jmharvey1/100mw-WSPR-Transmitter/README.md

# 100mw-WSPR-Transmitter
Material Needed to Replicate the 100mw Transmitter shown in the YouTube Video 
The Video can be seen here: https://youtu.be/ck376xusUuw
