jmharvey1/100mw-WSPR-Transmitter/EagleFiles/Adriuno_WSPR_Exciter/Arduino_VFO_AD9850.pdf

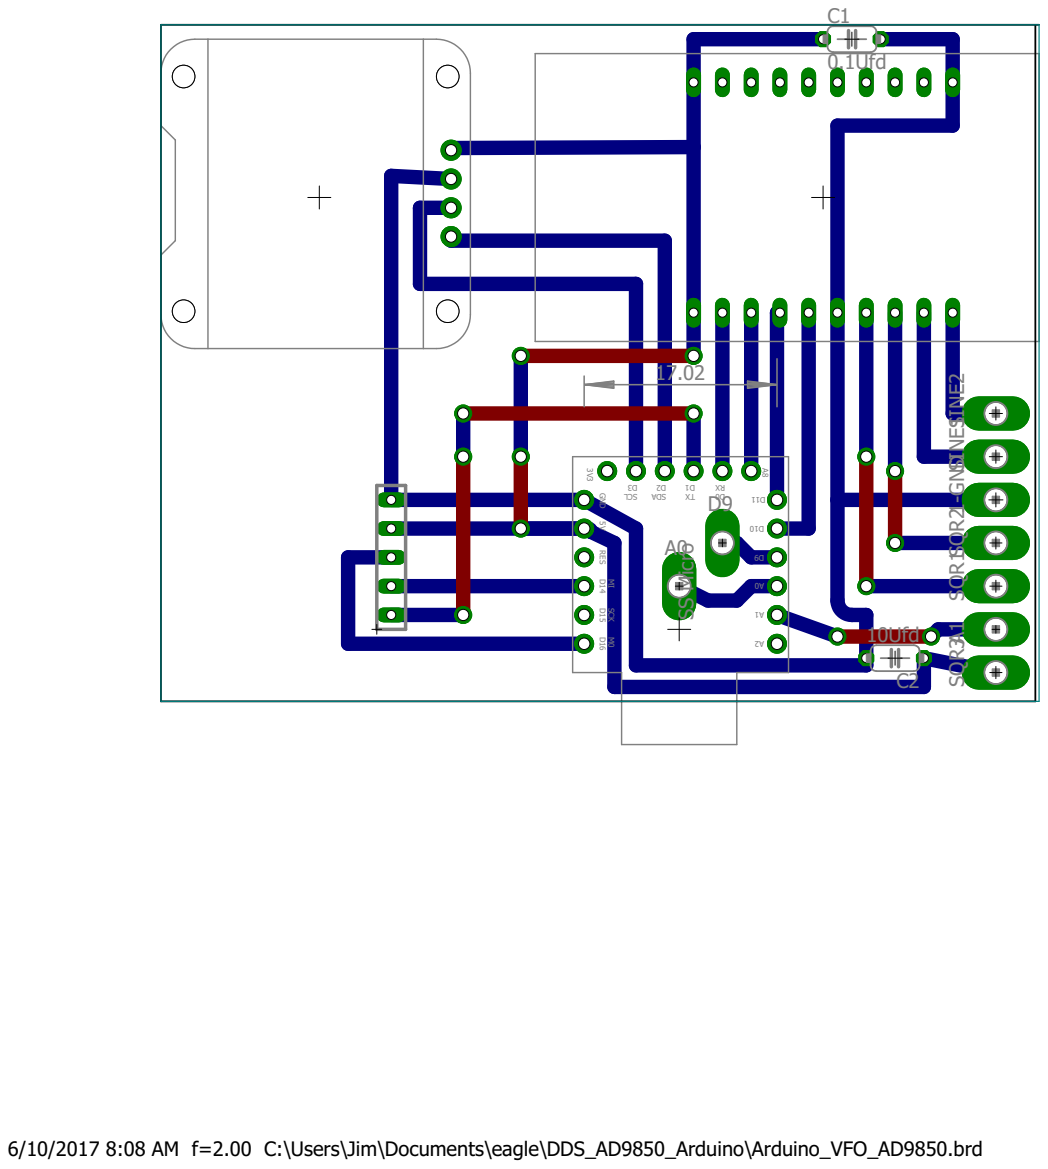
[picture p1: page 1]

6/10/2017 8:08 AM f=2.00 C:\Users\Jim\Documents\eagle\DDS_AD9850_Arduino\Arduino_VFO_AD9850.brd
