jmharvey1/100mw-WSPR-Transmitter/EagleFiles/Adriuno_WSPR_Exciter/Arduino_VFO_AD9850.brd

## EAGLE design EagleFiles/Adriuno_WSPR_Exciter/Arduino_VFO_AD9850.brd (2017-06-10)

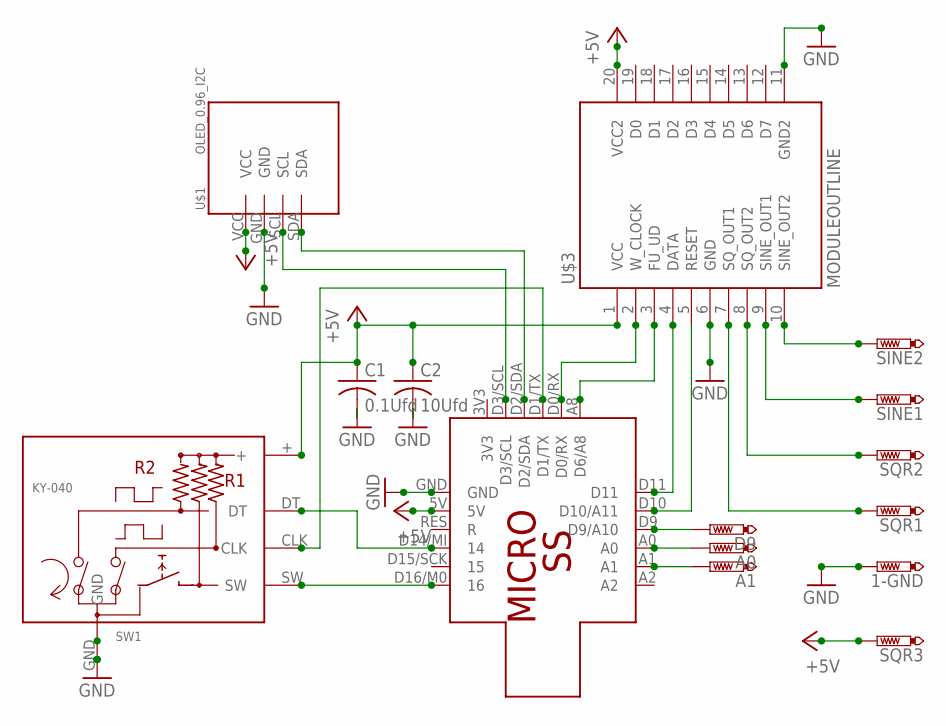
[picture p4: schematic Arduino_VFO_AD9850.sch]

Parts:
1-GND: 1 - GND; P1-20Y
A0, A1: 1 - GND; P1-20Y
C1: 0.1Ufd; C050-024X044
C2: 10Ufd; C050-024X044
D9: 1 - GND; P1-20Y
SINE1: 1 - GND; P1-20Y
SINE2: SINE2; P1-20Y
SQR1, SQR2, SQR3: 1 - GND; P1-20Y
SW1: KY-040; KY040
U$1: OLED_0.96_I2C
U$3: MODULEOUTLINE; MODULE_OUTLINE
U$4: SS_MICRO

Connections:
+5V: C1.1, C2.1, SQR3.TP, SW1.+, U$1.VCC, U$3.1 (VCC), U$3.20 (VCC2), U$4.5V
GND: 1-GND.TP, C1.2, C2.2, SW1.GND, U$1.GND, U$3.6 (GND), U$3.11 (GND2), U$4.GND
unnamed: U$1.SDA, U$4.D2/SDA
unnamed: U$1.SCL, U$4.D3/SCL
unnamed: SW1.CLK, U$4.D1/TX
unnamed: U$3.2 (W_CLOCK), U$4.D0/RX
unnamed: U$3.4 (DATA), U$4.D11
unnamed: U$3.5 (RESET), U$4.D10 (D10/A11)
unnamed: SW1.DT, U$4.D14/MI (14)
unnamed: SW1.SW, U$4.D16/M0 (16)
unnamed: SINE2.TP, U$3.10 (SINE_OUT2)
unnamed: SINE1.TP, U$3.9 (SINE_OUT1)
unnamed: SQR2.TP, U$3.8 (SQ_OUT2)
unnamed: SQR1.TP, U$3.7 (SQ_OUT1)
unnamed: D9.TP, U$4.D9 (D9/A10)
unnamed: A0.TP, U$4.A0
unnamed: A1.TP, U$4.A1
unnamed: U$3.3 (FU_UD), U$4.A8 (D6/A8)

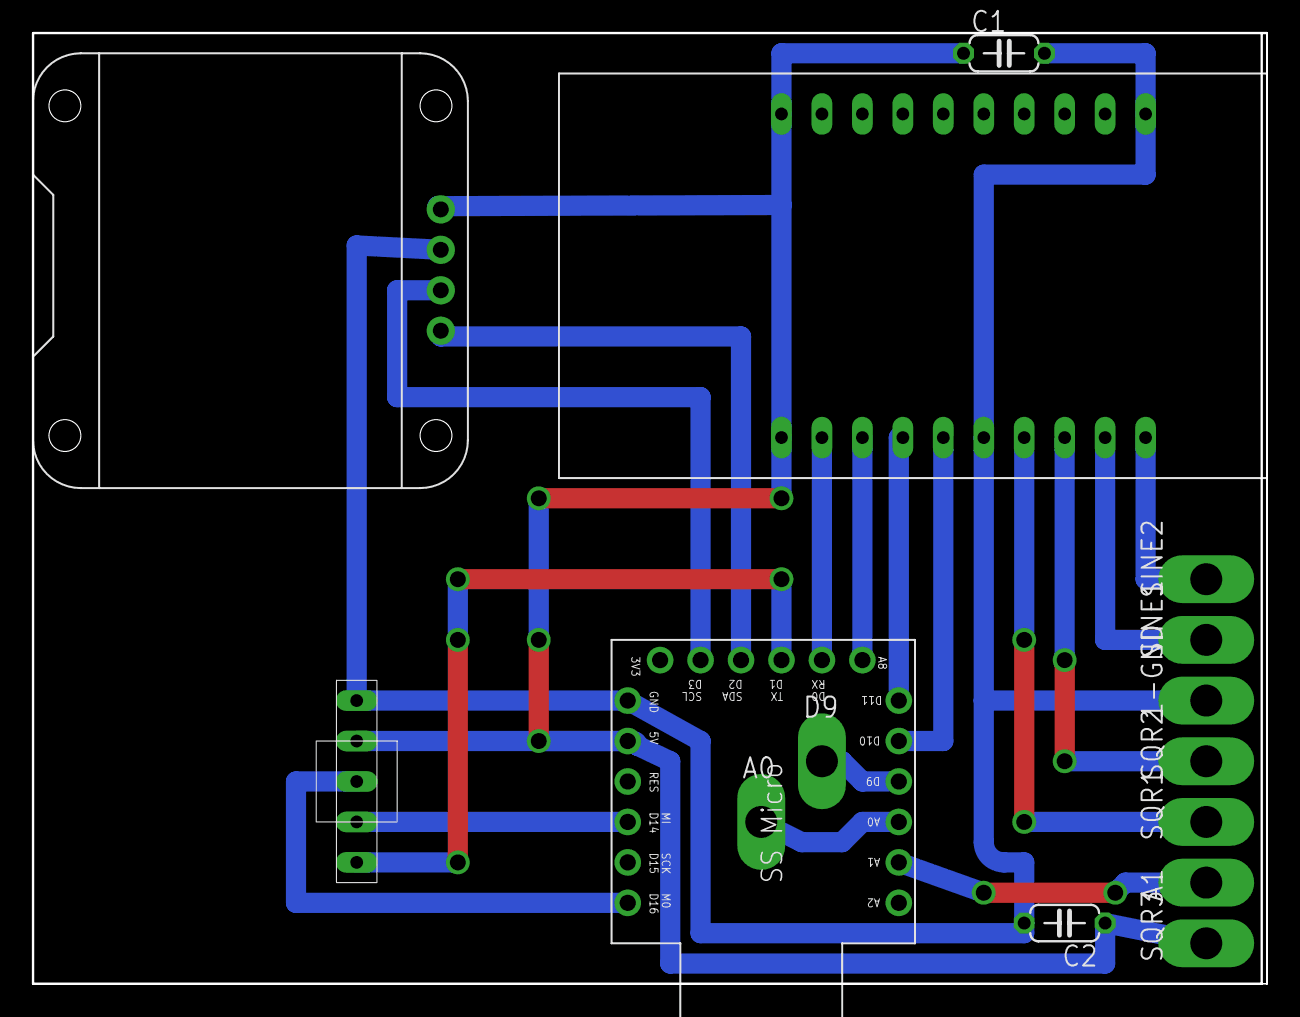
[picture p5: board Arduino_VFO_AD9850.brd from above]

Board: 2 copper layers, 77.5 x 59.7 mm, 15 parts (0 on the bottom side), 18 nets.
