jmharvey1/100mw-WSPR-Transmitter/(commit log)

2017-06-10 Added initial files
    Basic files used to build the 100mw WSPR transmitter shown in the video
    [40M_100mWattWSPRamp.brd, 40M_100mWattWSPRamp.sch, Arduino_VFO_AD9850.brd, Arduino_VFO_AD9850.sch]
2017-06-10 Re-Arranged File Layout
    Moved Arduino Sketch/Folder under Arduino Folder
2018-03-09 Added Notes/Comments for UNO based interface
    In addtion to comments for using an UNO type Arduino, changed the D and
    S arrays from interger to byte type to conserve SRAM space
2018-03-16 Added 20 Mtrs to Option Pick List
    Also added Coil data for 20 meter low pass filter to Coil Build
    Instructiion text file
